AidanAlvinGhylin/2028IONOSOUNDXMTRCVBOARD/README.md

# 2028IONOSOUNDXMTRCVBOARD
This repository houses all source code and files related to the development of Aidan's DDS-based ionospheric sounding devices, with the objective of providing a new automated method of tracking RF signal parameters including RF received signal time of flight and strength, as well as Doppler shift, across multiple propagation paths.
