AidanAlvinGhylin/2028IONOSOUNDXMTRCVBOARD/COSTAS_XmtRcv_V1_10_sch.pdf

### ABCDEF

### ABCDEF

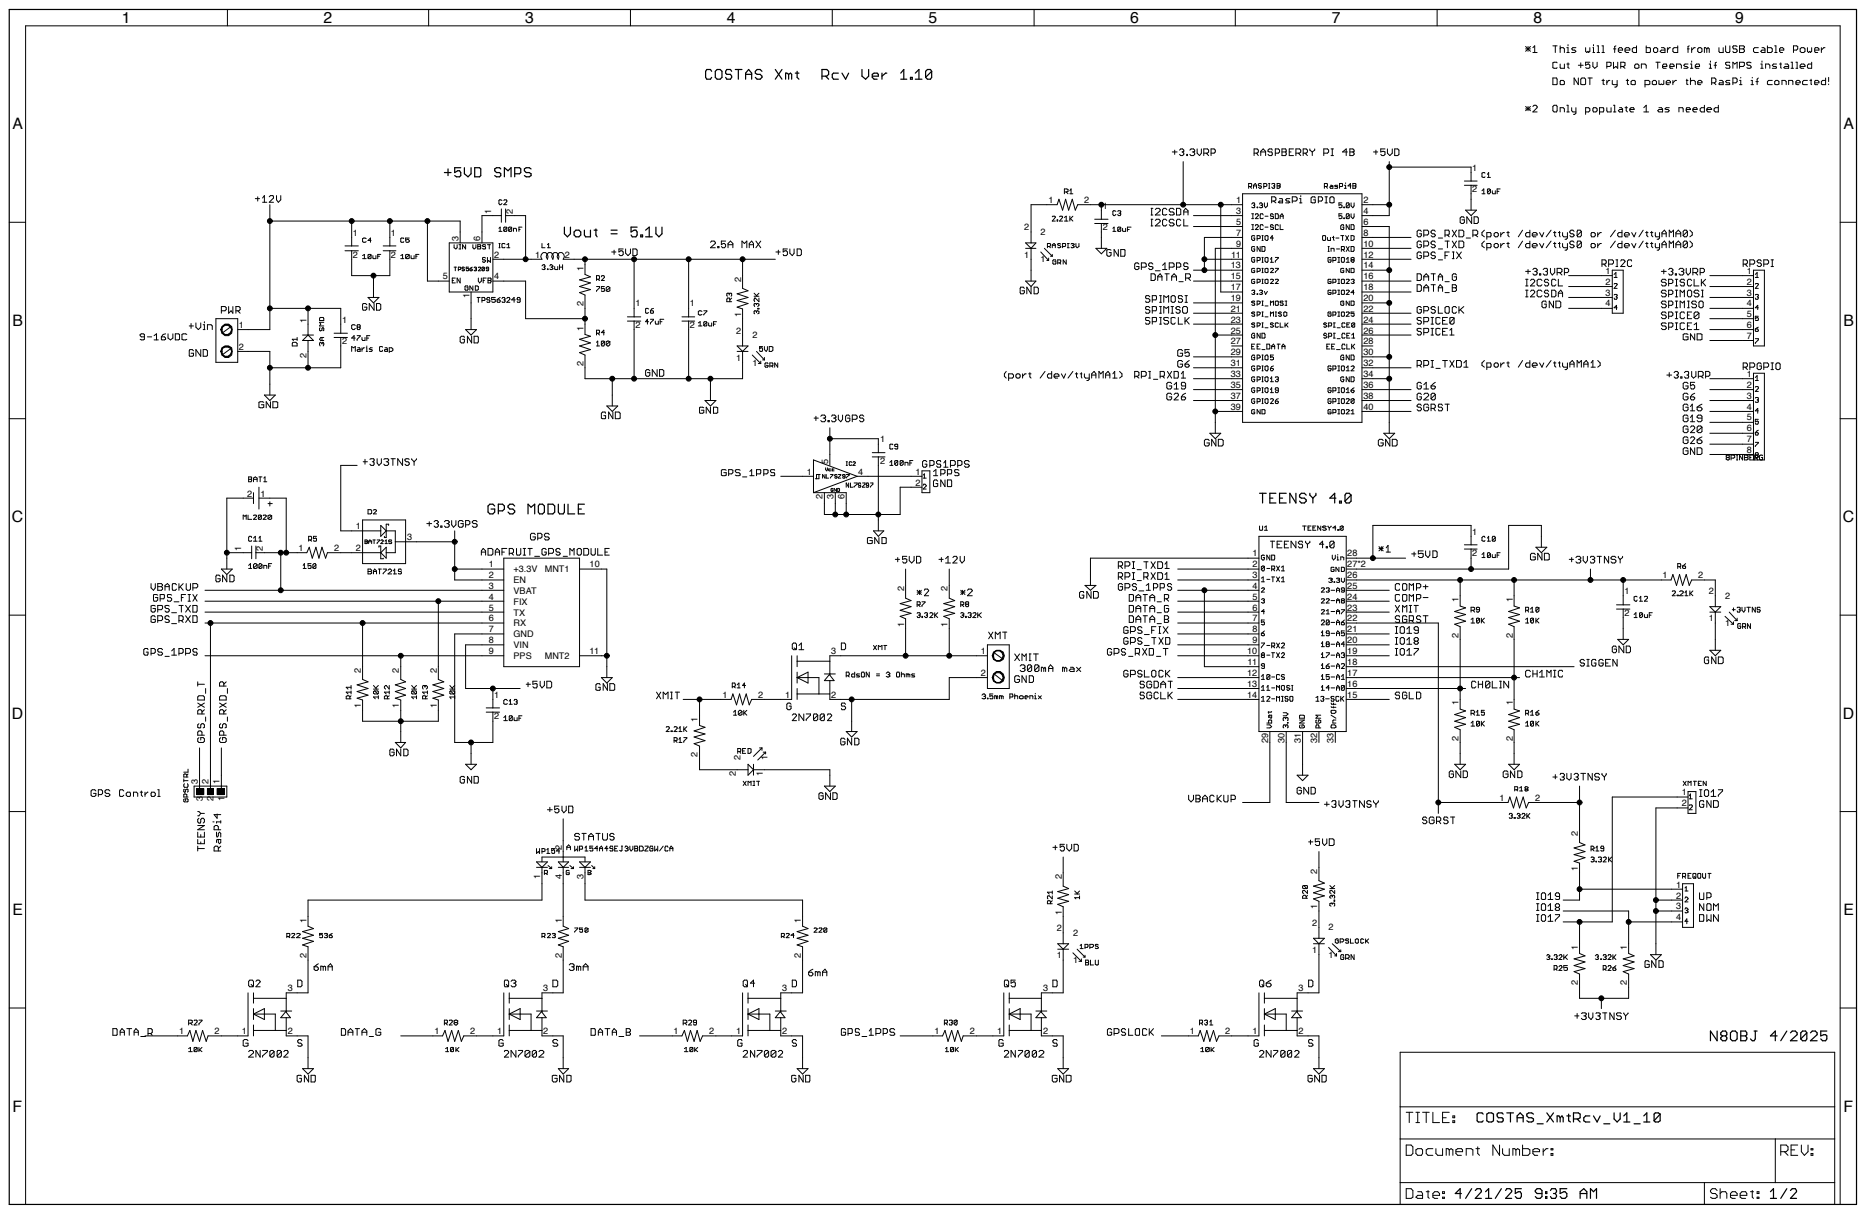
[picture p1: page 1]
VBAT; FIX; GND; VIN; PPS; MNT2; MNT1

21

21

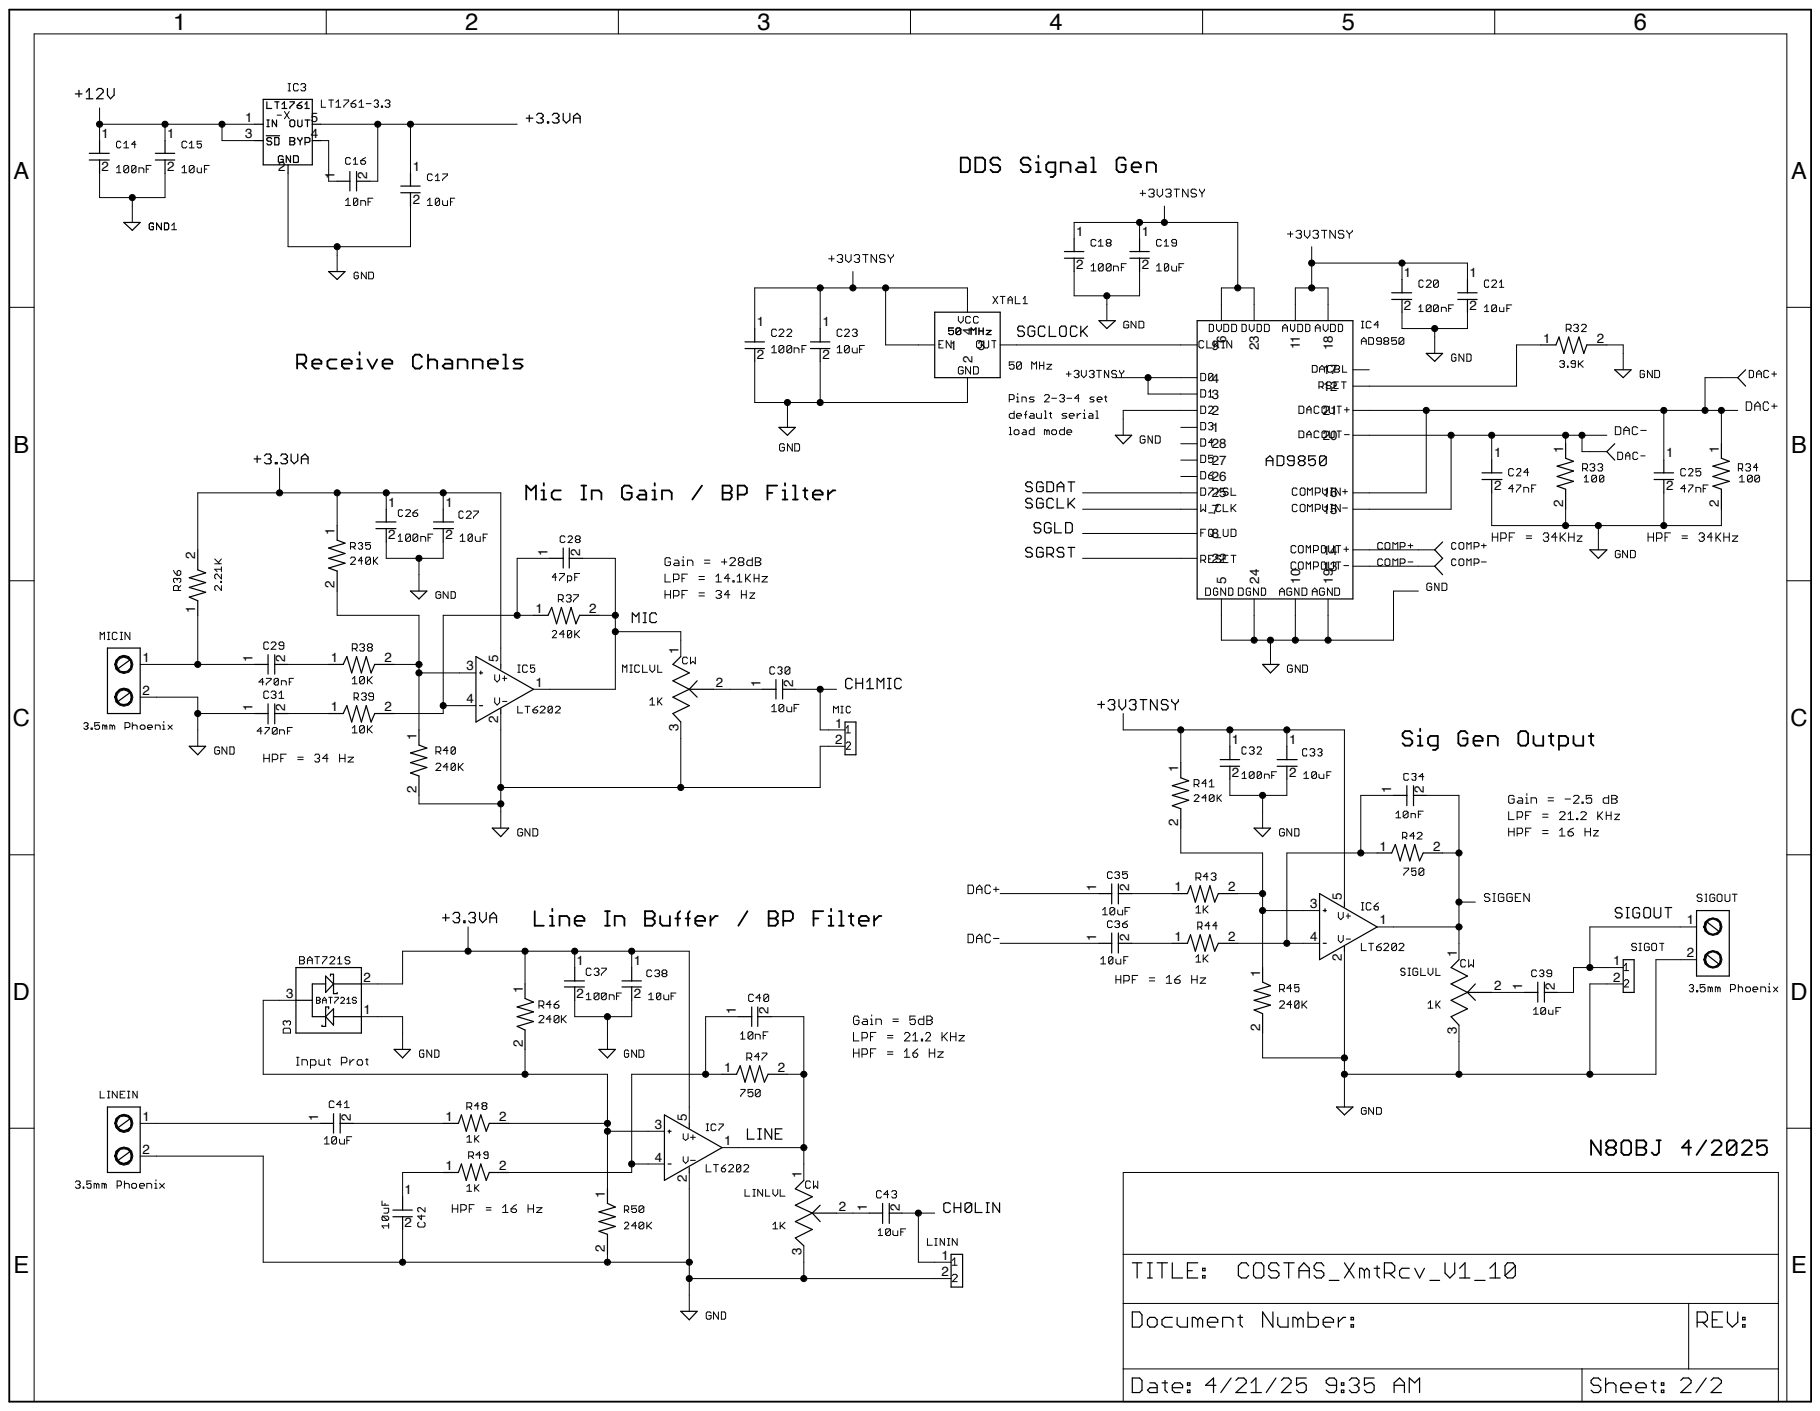
[picture p2: page 2]
ABCDE
