AidanAlvinGhylin/2028IONOSOUNDXMTRCVBOARD/(commit log)

2026-10-12 Create 2028XMITBoardKF8DIA
    This code is intended to run on the COSTAS XMT/RCV Board Ver 1.20 with a 1 MHz XTAL oscillator. This is not the final version of the code for 2028, as I plan to build up another version of this board that allows for wireless remote control.
2026-10-12 Add files via upload
    This is the schematic for the COSTAS XMT/RCV board built by John Gibbons N8OBJ. This schematic is not fully up to date, as we have since replaced the 50 MHz XTAL oscillator used for the AD9850 DDS with a 1 MHz XTAL.
2026-10-12 Add files via upload
    This is test code I developed as a precursor to 2027XMITBoardKF8DIA, as I was developing the UART interface on the Teensy 4.0 to track real time using NMEA data on the Teensy 4.0.
2026-10-12 Add files via upload
    This code is intended to run on the COSTAS XMT/RCV Board Ver 1.20, built by John Gibbons N8OBJ. This code implements transmission of modulated signal elements including UTC second ticks, BARKER codes, COSTAS arrays, constant audio tones, and station identification. The code also includes a UART interface architecture, designed to interface with the Adafruit GPS Breakout v3 at 9600 baud.
2026-10-12 Add files via upload
    This is a version of 2027ModulatedSignalKF8DIA that only transmits UTC second ticks. It does not include a UART interface architecture and therefore does not track real time.
